jameswilddev/quantum-monster/readme.md

# Quantum Monster

## Documentation

- [Assembly Instructions](./docs/assembly-instructions.md)
- [Hardware Design Notes](./docs/hardware-design-notes.md)
