jameswilddev/quantum-monster/src/hardware/shell/components/print_settings.scad

/**
 * The diameter of the nozzle, in millimeters.  No features narrower than this can be produced.
 */
function print_settings_nozzle_diameter() = 0.4;

/**
 * The height of a layer, in millimeters.  No features shorter than this can be produced.
 */
function print_settings_layer_height() = 0.2;

/**
 * Cut out of any concave corners to prevent pinching.
 */
function print_settings_concave_corner_cut_size() = 1;
