jameswilddev/quantum-monster/docs/assembly-instructions.md

# [Quantum Monster](../readme.md) > Assembly Instructions

TODO

## Programming

TODO

### Set fuses

TODO

```bash
avrdude -pm328p -PCOM3 -cavrisp -b19200 -U lfuse:w:0xe2:m -U hfuse:w:0xd1:m -U efuse:w:0xfd:m
```

### Flash

TODO
