jameswilddev/quantum-monster/src/hardware/pcb/quantum_monster.kicad_pcb

## KiCad design src/hardware/pcb/quantum_monster.kicad_pcb (2022-01-22)

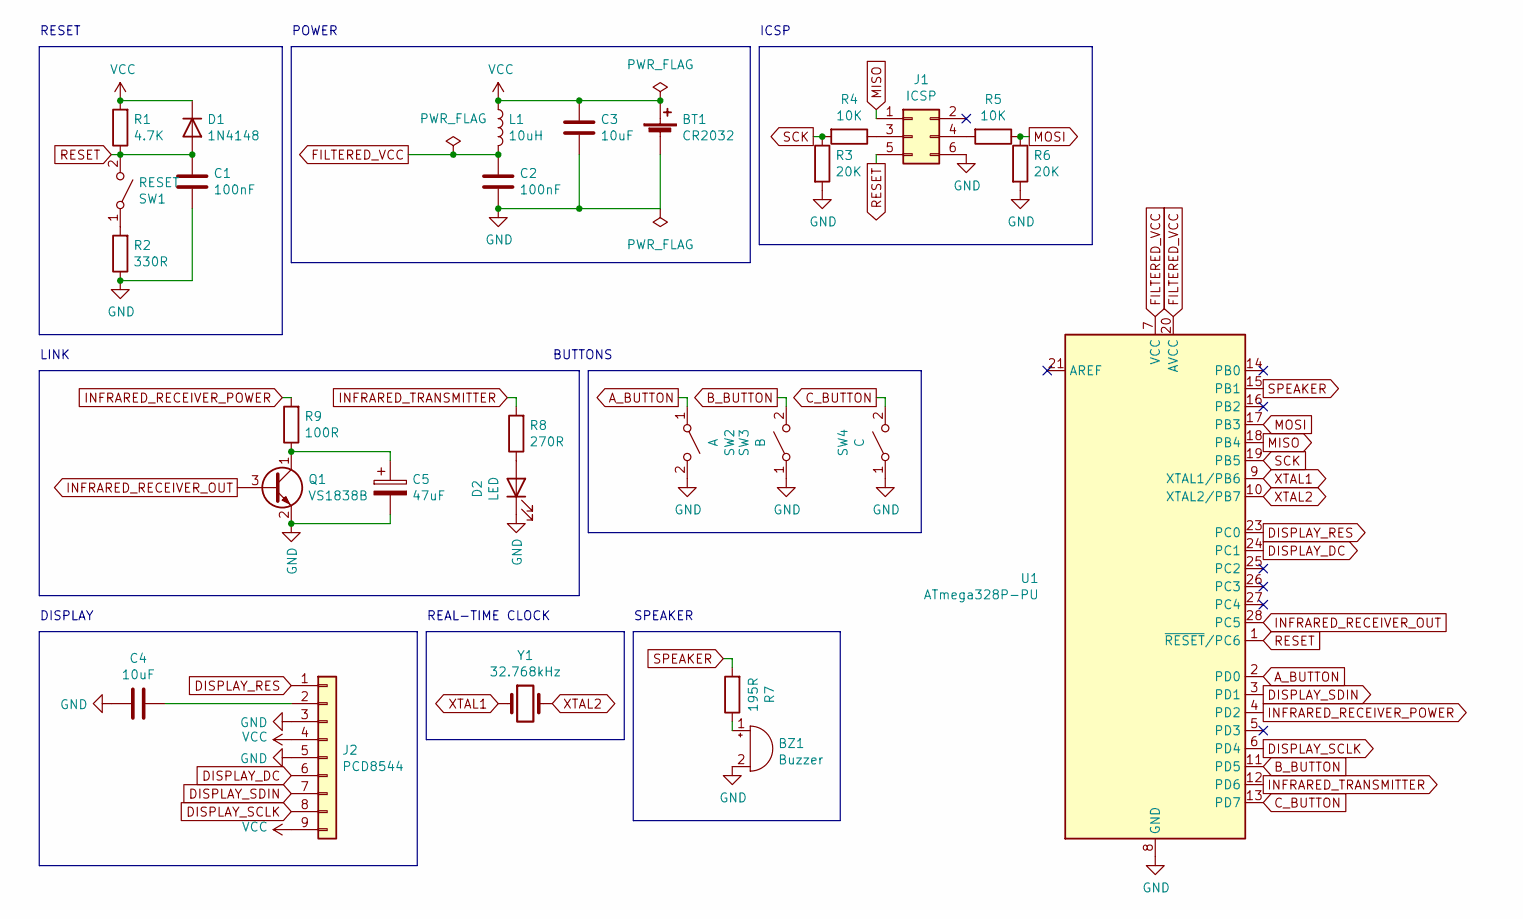
[picture p1: schematic quantum_monster.kicad_sch]

Parts:
BT1: CR2032
BZ1: Buzzer; MagneticBuzzer_PUI_AT-0927-TT-6-R
C1, C2: 100nF; C_Disc_D5.0mm_W2.5mm_P2.50mm
C3, C4: 10uF; C_Disc_D4.3mm_W1.9mm_P5.00mm
C5: 47uF; CP_Radial_D5.0mm_P2.00mm
D1: 1N4148; D_DO-34_SOD68_P7.62mm_Horizontal
D2: LED; LED_D5.0mm_IRBlack
J1: ICSP; PinHeader_2x03_P2.54mm_Vertical
J2: PCD8544
L1: 10uH; L_Axial_L5.3mm_D2.2mm_P7.62mm_Horizontal_Vishay_IM-1
Q1: VS1838B; TO-92L_Inline_Wide
R1: 4.7K; R_Axial_DIN0204_L3.6mm_D1.6mm_P7.62mm_Horizontal
R2: 330R; R_Axial_DIN0204_L3.6mm_D1.6mm_P7.62mm_Horizontal
R3, R6: 20K; R_Axial_DIN0204_L3.6mm_D1.6mm_P7.62mm_Horizontal
R4, R5: 10K; R_Axial_DIN0204_L3.6mm_D1.6mm_P7.62mm_Horizontal
R7: 195R; R_Axial_DIN0204_L3.6mm_D1.6mm_P7.62mm_Horizontal
R8: 270R; R_Axial_DIN0204_L3.6mm_D1.6mm_P7.62mm_Horizontal
R9: 100R; R_Axial_DIN0204_L3.6mm_D1.6mm_P7.62mm_Horizontal
SW1: RESET; SW_TH_Tactile_Omron_B3F-10xx
SW2: A; SW_TH_Tactile_Omron_B3F-10xx
SW3: B; SW_TH_Tactile_Omron_B3F-10xx
SW4: C; SW_TH_Tactile_Omron_B3F-10xx
U1: ATmega328P-PU; DIP-28_W7.62mm
Y1: 32.768kHz; Crystal_C38-LF_D3.0mm_L8.0mm_Vertical

Connections:
A_BUTTON: SW2.1 (A), U1.2 (PD0)
B_BUTTON: SW3.2 (B), U1.11 (PD5)
C_BUTTON: SW4.2 (B), U1.13 (PD7)
DISPLAY_DC: J2.6, U1.24 (PC1)
DISPLAY_RES: J2.1, U1.23 (PC0)
DISPLAY_SCLK: J2.8, U1.6 (PD4)
DISPLAY_SDIN: J2.7, U1.3 (PD1)
FILTERED_VCC: C2.1, L1.2, U1.7 (VCC), U1.20 (AVCC)
GND: BT1.2 (-), BZ1.2 (+), C1.2, C2.2, C3.2, C4.2, C5.2, D2.1 (K), J1.6, J2.3, J2.5, Q1.2 (E), R2.1, R3.2, R6.2, SW2.2 (B), SW3.1 (A), SW4.1 (A), U1.8 (GND), U1.22 (GND)
INFRARED_RECEIVER_OUT: Q1.3 (B), U1.28 (PC5)
INFRARED_RECEIVER_POWER: R9.2, U1.4 (PD2)
INFRARED_TRANSMITTER: R8.2, U1.12 (PD6)
MISO: J1.1, U1.18 (PB4)
MOSI: R5.1, R6.1, U1.17 (PB3)
unnamed: BZ1.1 (-), R7.1
unnamed: C4.1, J2.2
unnamed: C5.1, Q1.1 (C), R9.1
unnamed: D2.2 (A), R8.1
unnamed: J1.3, R4.1
unnamed: J1.4, R5.2
unnamed: R2.2, SW1.1 (A)
RESET: C1.1, D1.2 (A), J1.5, R1.1, SW1.2 (B), U1.1 (~RESET/PC6)
SCK: R3.1, R4.2, U1.19 (PB5)
SPEAKER: R7.2, U1.15 (PB1)
VCC: BT1.1 (+), C3.1, D1.1 (K), J2.4, J2.9, L1.1, R1.2
XTAL1: U1.9 (XTAL1/PB6), Y1.1
XTAL2: U1.10 (XTAL2/PB7), Y1.2

Notes on the sheet:
DISPLAY
RESET
ICSP
BUTTONS
REAL-TIME CLOCK
SPEAKER
POWER
LINK

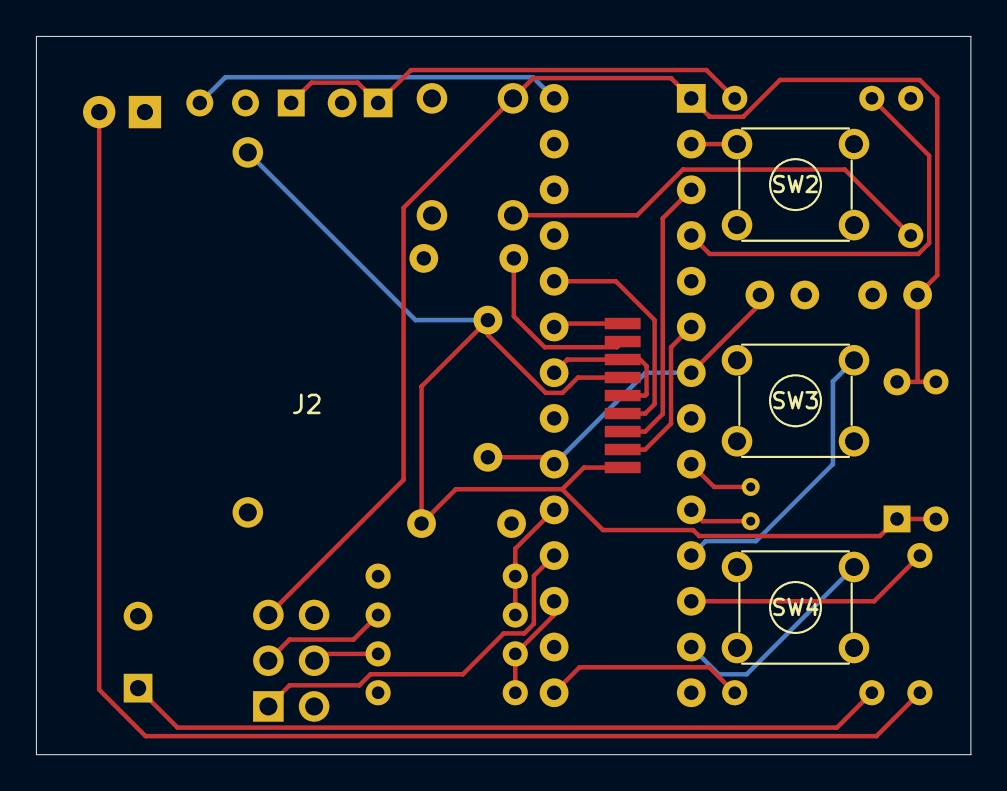
[picture p2: board quantum_monster.kicad_pcb from above]

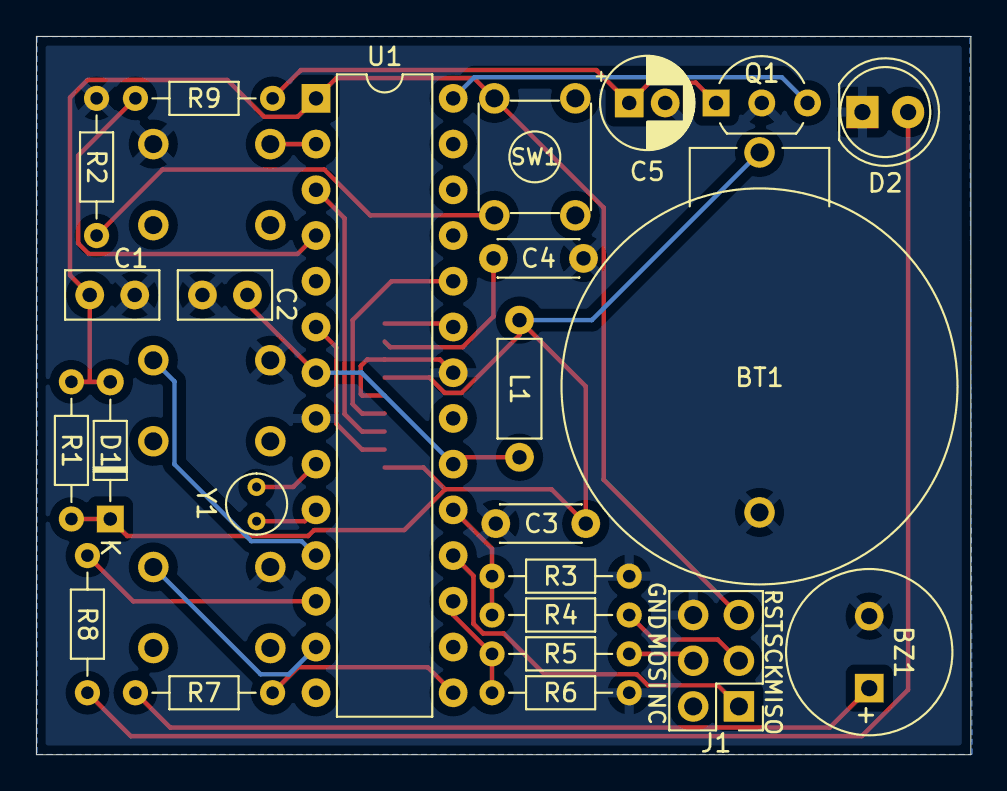
[picture p3: board quantum_monster.kicad_pcb from below]

Board: 2 copper layers, 51.9 x 39.9 mm, 28 parts (24 on the bottom side), 27 nets.
