jameswilddev/quantum-monster/(commit log)

2022-01-01 Begin structuring project.
    [quantum_monster.kicad_pcb, quantum_monster.sch]
2022-01-01 Fix speaker build problems.
    [speaker.c]
2022-01-01 Fix main build problems.
    [main.c]
2022-01-02 Continue experimenting with hardware design.
    [quantum_monster.kicad_pcb, quantum_monster.sch]
2022-01-03 Start adding shell measurements.
    [display.scad, pcb.scad]
2022-01-03 Begin a total redesign of the software.
    [main.c, speaker.c, storage.c, storage.h]
2022-01-03 Move all PCB designs under a subdirectory.
    [quantum_monster.kicad_pcb, quantum_monster.sch]
2022-01-06 Placeholder assembly instructions.
2022-01-08 Redesign speaker API to work with frequencies rather than timer values.
2022-01-08 Add screw measurements.
    [screw.scad]
2022-01-08 Take PCB and display measurements for a LCD test board.
    [display.scad, pcb.scad]
2022-01-08 Model front shell for LCD test.
    [front.scad]
2022-01-08 Fix pull ups not pulling up.
    [pin_mapping.c]
2022-01-12 Move speaker to timer 1.
2022-01-12 Continue PCB design.
    [quantum_monster.kicad_pcb, quantum_monster.sch]
2022-01-16 Adjust PCB outline to allow room for display retainer.
    [quantum_monster.kicad_pcb]
2022-01-16 Continue building out the shell.
    [back.scad, button.scad, button_cap.scad, button_cutout.scad, concave_corner_cuts.scad, corner.scad, display.scad, display_cutout.scad]
2022-01-19 Increase button cap gap.
    [button.scad]
2022-01-20 Reduce PCB size.
    [quantum_monster.kicad_pcb, quantum_monster.sch]
2022-01-20 Add missing include.
    [button.scad]
2022-01-20 Thicken the display bezel to make the button area thicker.
    [display.scad]
2022-01-20 Adjust screw measurements.
    [screw.scad]
2022-01-20 Halve PCB back clearance.
    [pcb.scad]
2022-01-20 Fix the back not having cutouts.
    [back.scad, concave_corner_cuts.scad, display.scad, display_wall_corner_cuts.scad, front.scad, pcb.scad, pcb_retainer_corner_cuts.scad]
2022-01-20 Add an initial draft of a thicker wall.
    [wall_wide.scad]
2022-01-22 Begin layout changes to accommodate correct display dimensions.
    [quantum_monster.kicad_pcb]
2022-01-22 Update measurements to match updated display.
    [display.scad, pcb.scad]
2022-01-22 Remove display clip.
    [display.scad, front.scad]
2022-01-22 Add a spacer between the PCB and display.
    [display.scad, display_spacer.scad]
2022-01-22 Redesign the infrared cutout.
    [wall.scad]
2022-01-22 Upgrade to KiCad 6.
    [quantum_monster.kicad_pcb, quantum_monster.kicad_sch, quantum_monster.sch]
2022-01-22 Initial production prototype of PCB.
    [quantum_monster.kicad_pcb, quantum_monster.kicad_sch]
2022-01-22 Fix mispositioned corner cuts.
    [pcb.scad]
2022-01-22 Update button positions to match PCB.
    [button.scad]
2022-01-22 Update infrared cutout position.
    [infrared.scad]
2022-01-22 Add a keychain cutout to the wall.
    [keychain.scad, wall_wide.scad]
2022-01-22 Update pin mapping.
2022-01-22 Add PCB model.
    [pcb.scad]
2022-01-22 Add framebuffer argument.
2022-01-23 Fix out-of-order display addressing.
    [display.c]
2022-01-27 Thicken the plate and embed the screws deeper.
    [plate.scad, screw.scad]
2022-01-28 Milliseconds -> delay.
2022-02-02 Adjust button properties.
    [button.scad]
2022-02-02 Increase plate thickness to allow for deeper screws.
    [plate.scad]
2022-02-02 Deepen screws.
    [screw.scad]
2022-02-02 Reduce screw size.
    [corner.scad, screw.scad, side_cutout.scad]
2022-02-04 Rebuild shell.
    [back.scad, button.scad, button_cap.scad, button_cutout.scad, corner.scad, display.scad, display_cutout.scad, display_spacer.scad]
